hadongz/CodeName02/CodeName02.kicad_pcb

## KiCad design CodeName02.kicad_pcb (2025-10-10)

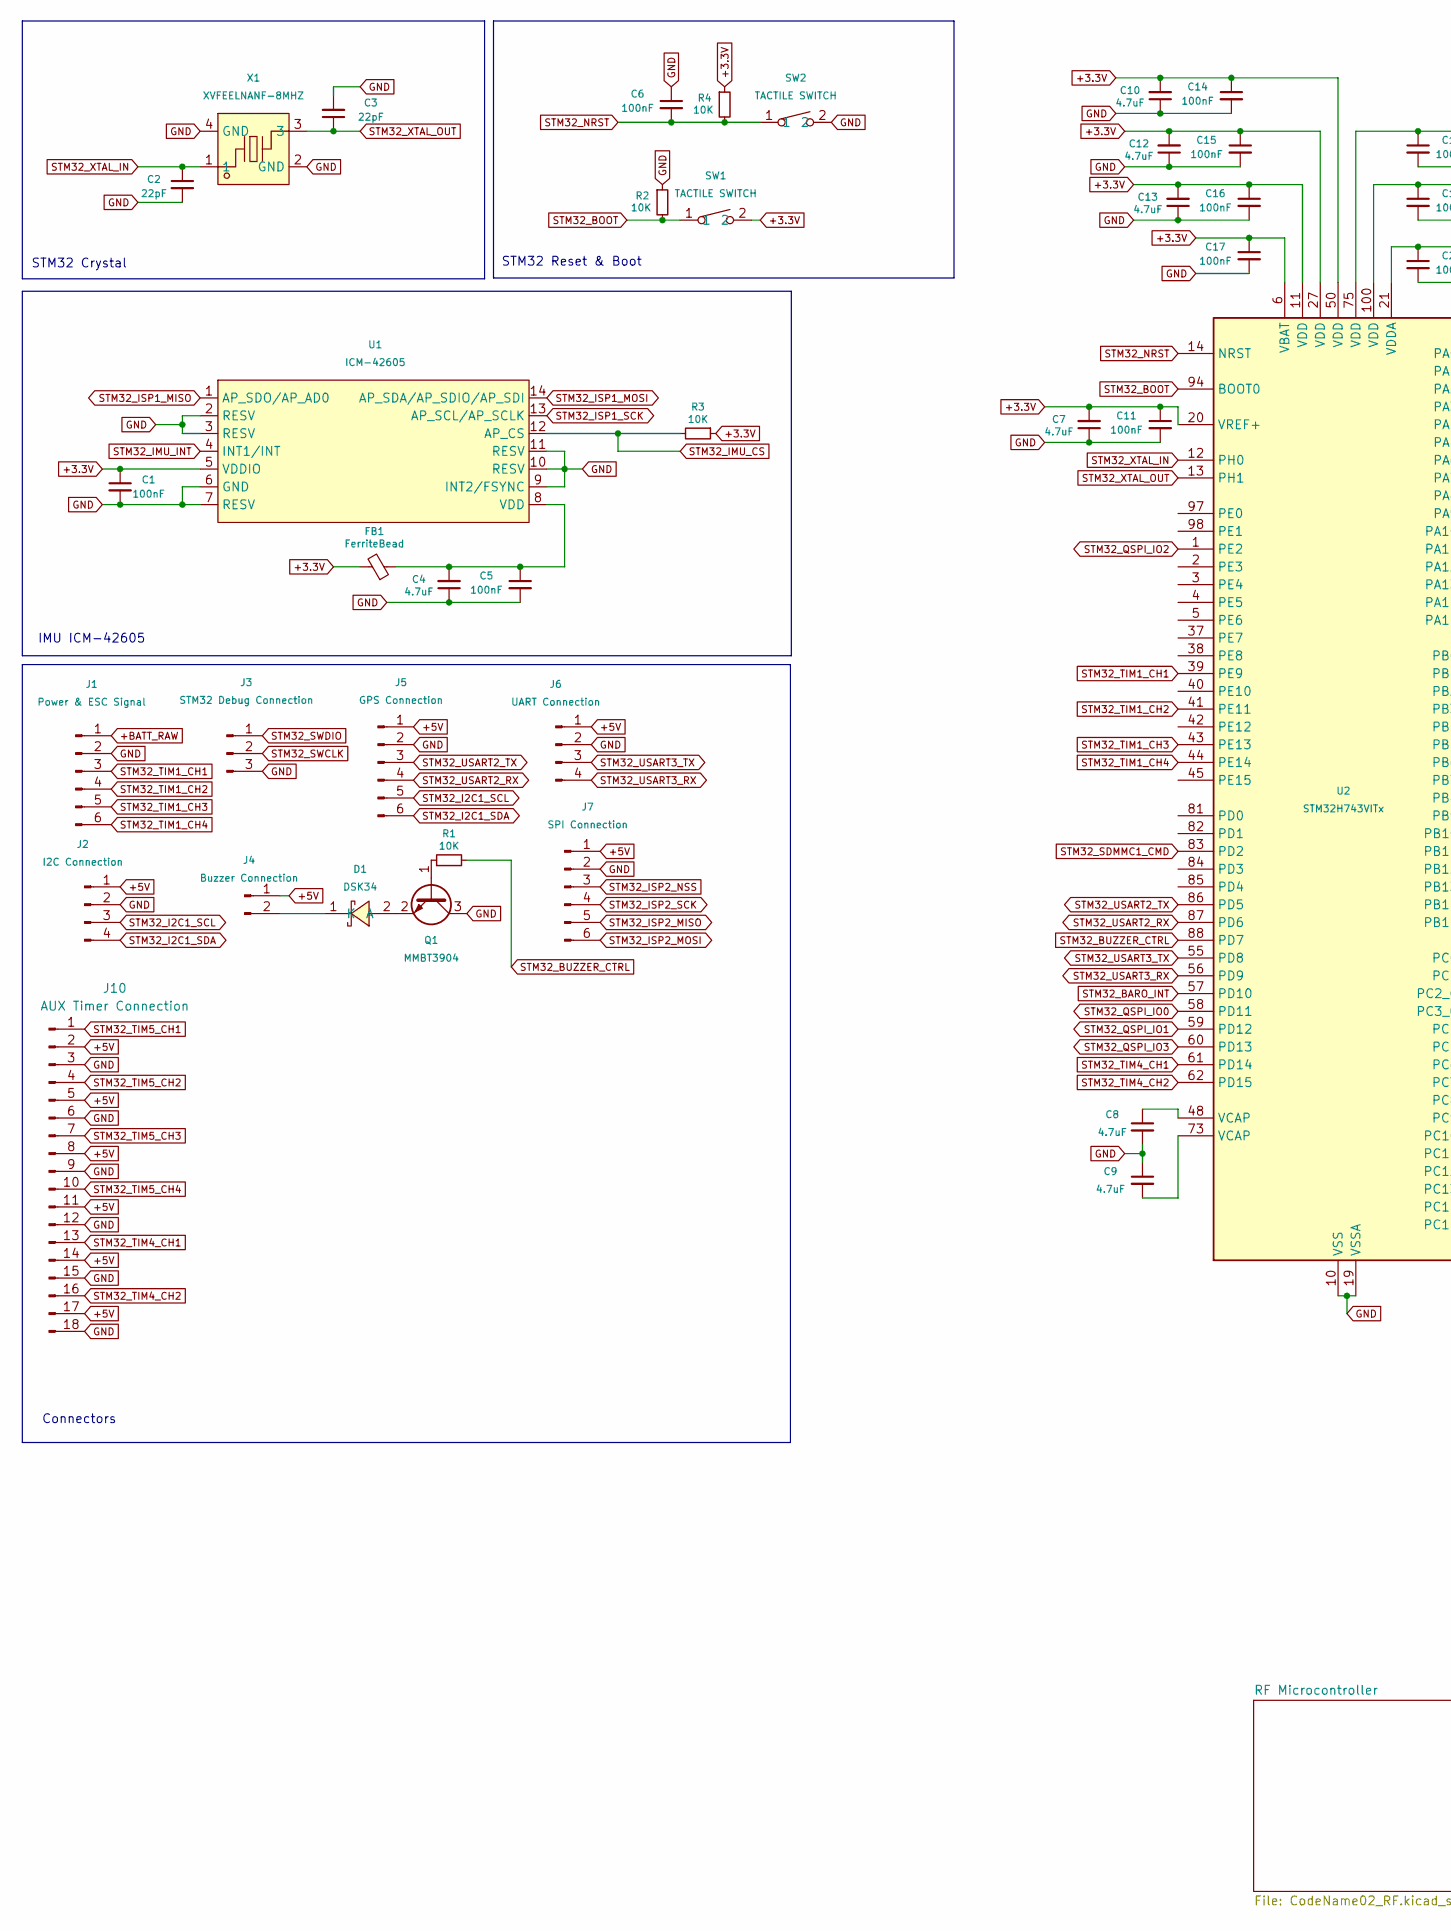
[picture p1: schematic CodeName02.kicad_sch, part in row 1, column 1]

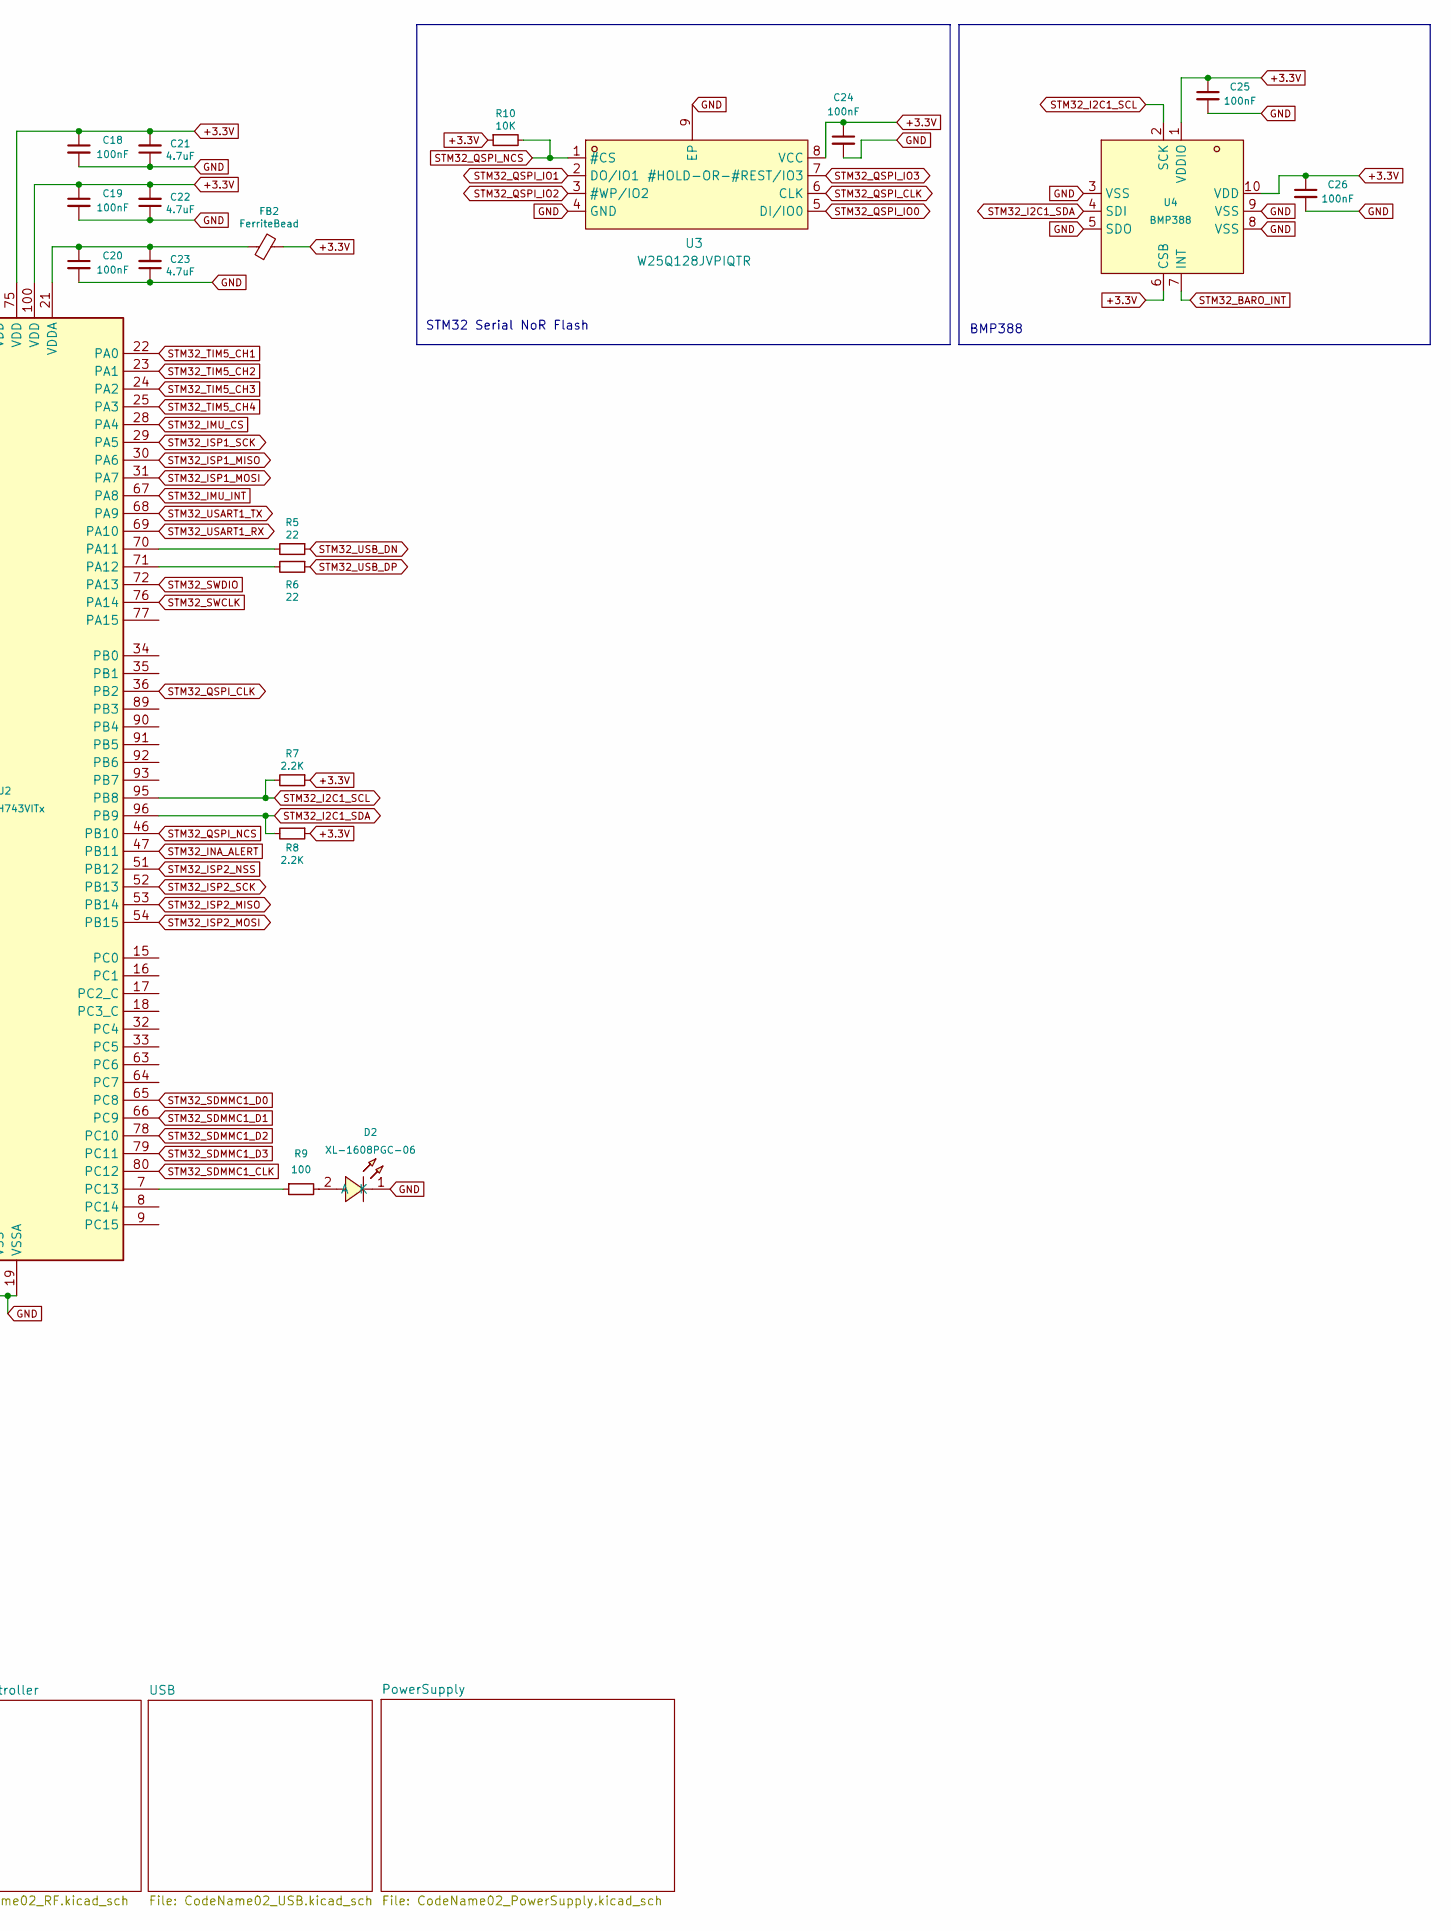
[picture p2: schematic CodeName02.kicad_sch, part in row 1, column 2]

Parts:
C1, C5, C6, C11, C14, C15, C16, C17, C18, C19, C20, C24, C25, C26: 100nF; C_0603_1608Metric
C2, C3: 22pF; C_0603_1608Metric
C4, C7, C8, C9, C10, C12, C13, C21, C22, C23: 4.7uF; C_0603_1608Metric
D1: DSK34; SOD-123FL_L2.7-W1.8-LS3.8-RD; LCSC Part C727076
D2: XL-1608PGC-06; LED0603-RD_GREEN; LCSC Part C7371905
FB1, FB2: FerriteBead; L_0603_1608Metric
J1: Power & ESC Signal; JST_GH_SM06B-GHS-TB_1x06-1MP_P1.25mm_Horizontal
J2: I2C Connection; JST_GH_BM04B-GHS-TBT_1x04-1MP_P1.25mm_Vertical
J3: STM32 Debug Connection; PinHeader_1x03_P2.54mm_Vertical_Custom
J4: Buzzer Connection; JST_GH_SM02B-GHS-TB_1x02-1MP_P1.25mm_Horizontal
J5: GPS Connection; JST_GH_SM06B-GHS-TB_1x06-1MP_P1.25mm_Horizontal
J6: UART Connection; JST_GH_SM04B-GHS-TB_1x04-1MP_P1.25mm_Horizontal
J7: SPI Connection; JST_GH_SM06B-GHS-TB_1x06-1MP_P1.25mm_Horizontal
J10: AUX Timer Connection; PinHeader_3Row_Custom
Q1: MMBT3904; SOT-23
R1, R2, R3, R4, R10: 10K; R_0603_1608Metric
R5, R6: 22; R_0603_1608Metric
R7, R8: 2.2K; R_0603_1608Metric
R9: 100; R_0603_1608Metric
SW1, SW2: TACTILE SWITCH; KEY-SMD_L4.0-W3.0-LS4.9-1; LCSC Part C49234124
U1: ICM-42605; LGA-14_L3.0-W2.5-P0.50-TL; LCSC Part C2655099
U2: STM32H743VITx; LQFP-100_14x14mm_P0.5mm
U3: W25Q128JVPIQTR; WSON-8_L6.0-W5.0-P1.27-BL; LCSC Part C190862
U4: BMP388; SENSORM-SMD_BMP388; LCSC Part C779278
X1: XVFEELNANF-8MHZ; CRYSTAL-SMD_4P-L5.0-W3.2-BL-1; LCSC Part C5160132

Connections:
+3.3V: C1.1, C7.2, C10.2, C11.1, C12.2, C13.2, C14.1, C15.1, C16.1, C17.1, C18.1, C19.1, C21.2, C22.2, C24.1, C25.1, C26.1, FB1.2, FB2.2, R3.1, R4.1, R7.1, R8.1, R10.1, SW1.2, U1.5 (VDDIO), U2.6 (VBAT), U2.11 (VDD), U2.20 (VREF+), U2.27 (VDD), U2.50 (VDD), U2.75 (VDD), U2.100 (VDD), U3.8 (VCC), U4.1 (VDDIO), U4.6 (CSB), U4.10 (VDD); also elsewhere on the board
+5V: J2.1, J4.1, J5.1, J6.1, J7.1, J10.2, J10.5, J10.8, J10.11, J10.14, J10.17; also elsewhere on the board
+BATT_RAW: J1.1; also elsewhere on the board
GND: C1.2, C2.2, C3.2, C4.1, C5.2, C6.1, C7.1, C8.2, C9.1, C10.1, C11.2, C12.1, C13.1, C14.2, C15.2, C16.2, C17.2, C18.2, C19.2, C20.2, C21.1, C22.1, C23.1, C24.2, C25.2, C26.2, D2.1 (K), J1.2, J1.MP, J2.2, J3.3, J4.MP, J5.2, J5.MP, J6.2, J6.MP, J7.2, J7.MP, J10.3, J10.6, J10.9, J10.12, J10.15, J10.18, Q1.3 (C), R2.1, SW2.2, U1.2 (RESV), U1.3 (RESV), U1.6 (GND), U1.7 (RESV), U1.9 (INT2/FSYNC), U1.10 (RESV), U1.11 (RESV), U2.10 (VSS), U2.19 (VSSA), U2.26 (VSS), U2.49 (VSS), U2.74 (VSS), U2.99 (VSS), U3.4 (GND), U3.9 (EP), U4.3 (VSS), U4.5 (SDO), U4.8 (VSS), U4.9 (VSS), X1.2 (GND), X1.4 (GND); also elsewhere on the board
unnamed: C8.1, U2.48 (VCAP)
unnamed: C9.2, U2.73 (VCAP)
unnamed: D1.2 (A), Q1.2 (E)
unnamed: D1.1 (K), J4.2
unnamed: D2.2 (A), R9.2
unnamed: Q1.1 (B), R1.1
unnamed: C4.2, C5.1, FB1.1, U1.8 (VDD)
unnamed: R5.2, U2.70 (PA11)
unnamed: R6.2, U2.71 (PA12)
unnamed: R9.1, U2.7 (PC13)
unnamed: C20.1, C23.2, FB2.1, U2.21 (VDDA)
STM32_BARO_INT: U2.57 (PD10), U4.7 (INT)
STM32_BOOT: R2.2, SW1.1, U2.94 (BOOT0)
STM32_BUZZER_CTRL: R1.2, U2.88 (PD7)
STM32_I2C1_SCL: J2.3, J5.5, R7.2, U2.95 (PB8), U4.2 (SCK); also elsewhere on the board
STM32_I2C1_SDA: J2.4, J5.6, R8.2, U2.96 (PB9), U4.4 (SDI); also elsewhere on the board
STM32_IMU_CS: R3.2, U1.12 (AP_CS), U2.28 (PA4)
STM32_IMU_INT: U1.4 (INT1/INT), U2.67 (PA8)
STM32_INA_ALERT: U2.47 (PB11); also elsewhere on the board
STM32_ISP1_MISO: U1.1 (AP_SDO/AP_AD0), U2.30 (PA6)
STM32_ISP1_MOSI: U1.14 (AP_SDA/AP_SDIO/AP_SDI), U2.31 (PA7)
STM32_ISP1_SCK: U1.13 (AP_SCL/AP_SCLK), U2.29 (PA5)
STM32_ISP2_MISO: J7.5, U2.53 (PB14)
STM32_ISP2_MOSI: J7.6, U2.54 (PB15)
STM32_ISP2_NSS: J7.3, U2.51 (PB12)
STM32_ISP2_SCK: J7.4, U2.52 (PB13)
STM32_NRST: C6.2, R4.2, SW2.1, U2.14 (NRST)
STM32_QSPI_CLK: U2.36 (PB2), U3.6 (CLK)
STM32_QSPI_IO0: U2.58 (PD11), U3.5 (DI/IO0)
STM32_QSPI_IO1: U2.59 (PD12), U3.2 (DO/IO1)
STM32_QSPI_IO2: U2.1 (PE2), U3.3 (#WP/IO2)
STM32_QSPI_IO3: U2.60 (PD13), U3.7 (#HOLD-OR-#REST/IO3)
STM32_QSPI_NCS: R10.2, U2.46 (PB10), U3.1 (#CS)
STM32_SDMMC1_CLK: U2.80 (PC12)
STM32_SDMMC1_CMD: U2.83 (PD2)
STM32_SDMMC1_D0: U2.65 (PC8)
STM32_SDMMC1_D1: U2.66 (PC9)
STM32_SDMMC1_D2: U2.78 (PC10)
STM32_SDMMC1_D3: U2.79 (PC11)
STM32_SWCLK: J3.2, U2.76 (PA14)
STM32_SWDIO: J3.1, U2.72 (PA13)
STM32_TIM1_CH1: J1.3, U2.39 (PE9)
STM32_TIM1_CH2: J1.4, U2.41 (PE11)
STM32_TIM1_CH3: J1.5, U2.43 (PE13)
STM32_TIM1_CH4: J1.6, U2.44 (PE14)
STM32_TIM4_CH1: J10.13, U2.61 (PD14)
STM32_TIM4_CH2: J10.16, U2.62 (PD15)
STM32_TIM5_CH1: J10.1, U2.22 (PA0)
STM32_TIM5_CH2: J10.4, U2.23 (PA1)
STM32_TIM5_CH3: J10.7, U2.24 (PA2)
STM32_TIM5_CH4: J10.10, U2.25 (PA3)
STM32_USART1_RX: U2.69 (PA10); also elsewhere on the board
STM32_USART1_TX: U2.68 (PA9); also elsewhere on the board
STM32_USART2_RX: J5.4, U2.87 (PD6)
STM32_USART2_TX: J5.3, U2.86 (PD5)
STM32_USART3_RX: J6.4, U2.56 (PD9)
STM32_USART3_TX: J6.3, U2.55 (PD8)
STM32_USB_DN: R5.1; also elsewhere on the board
STM32_USB_DP: R6.1; also elsewhere on the board
STM32_XTAL_IN: C2.1, U2.12 (PH0), X1.1
STM32_XTAL_OUT: C3.1, U2.13 (PH1), X1.3

Notes on the sheet:
STM32 Crystal
STM32 Reset & Boot
Connectors
BMP388
STM32 Serial NoR Flash
IMU ICM-42605

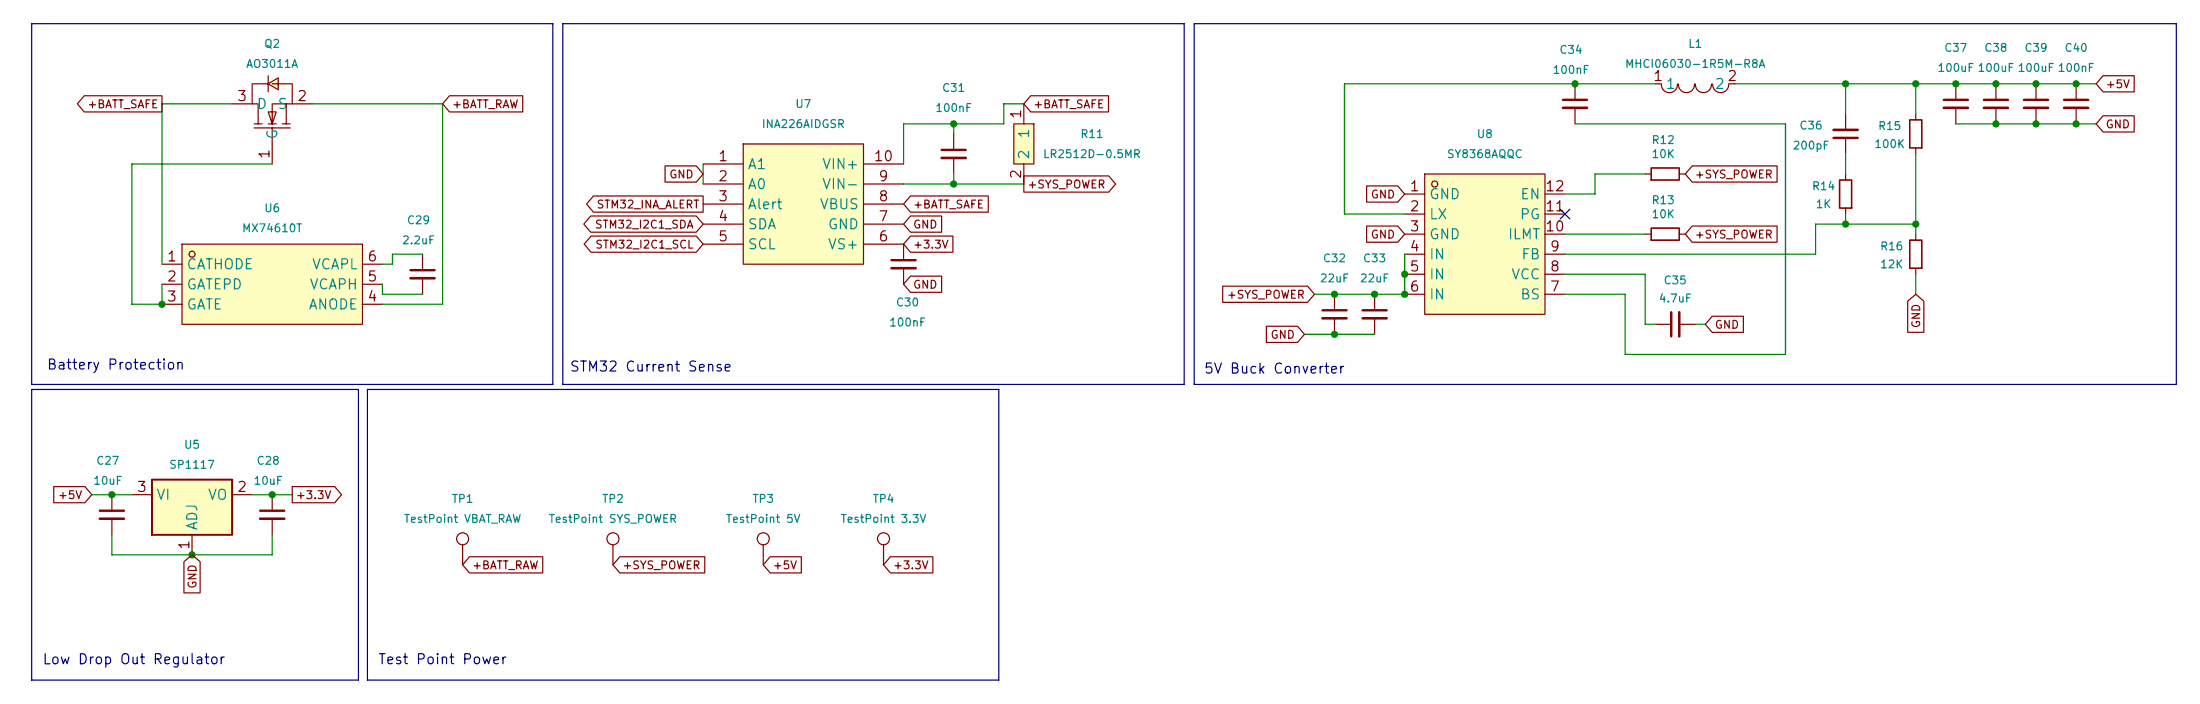
[picture p3: schematic CodeName02_PowerSupply.kicad_sch]

Parts:
C27, C28: 10uF; C_0805_2012Metric
C29: 2.2uF; C_0603_1608Metric
C30, C31, C34, C40: 100nF; C_0603_1608Metric
C32, C33: 22uF; C_0805_2012Metric
C35: 4.7uF; C_0603_1608Metric
C36: 200pF; C_0603_1608Metric
C37, C38, C39: 100uF; C_1206_3216Metric
L1: MHCI06030-1R5M-R8A; IND-SMD_L7.3-W6.6; LCSC Part C329386
Q2: AO3011A; SOT-23-3_L2.9-W1.6-P1.90-LS2.8-BR; LCSC Part C49046454
R11: LR2512D-0.5MR; RES-SMD_L6.4-W3.2_C500733; LCSC Part C500733
R12, R13: 10K; R_0603_1608Metric
R14: 1K; R_0603_1608Metric
R15: 100K; R_0603_1608Metric
R16: 12K; R_0603_1608Metric
TP1: TestPoint VBAT_RAW; TestPoint_Pad_D2.0mm
TP2: TestPoint SYS_POWER; TestPoint_Pad_D2.0mm
TP3: TestPoint 5V; TestPoint_Pad_D2.0mm
TP4: TestPoint 3.3V; TestPoint_Pad_D2.0mm
U5: SP1117; SOT-223-3_TabPin2
U6: MX74610T; SOT-23-6_L2.9-W1.6-P0.95-LS2.8-BL-1; LCSC Part C19078229
U7: INA226AIDGSR; MSOP-10_L3.0-W3.0-P0.50-LS5.0-BL; LCSC Part C49851
U8: SY8368AQQC; QFN-12_L3.0-W3.0-P0.45-TL-EP; LCSC Part C207642

Connections:
+3.3V: C28.1, C30.1, TP4.1, U5.2 (VO), U7.6 (VS+); also elsewhere on the board
+5V: C27.1, C36.2, C37.1, C38.1, C39.1, C40.1, L1.2, R15.2, TP3.1, U5.3 (VI); also elsewhere on the board
+BATT_RAW: Q2.2 (S), TP1.1, U6.4 (ANODE); also elsewhere on the board
+BATT_SAFE: C31.1, Q2.3 (D), R11.1, U6.1 (CATHODE), U7.8 (VBUS), U7.10 (VIN+)
+SYS_POWER: C31.2, C32.1, C33.1, R11.2, R12.2, R13.2, TP2.1, U7.9 (VIN-), U8.4 (IN), U8.5 (IN), U8.6 (IN); also elsewhere on the board
GND: C27.2, C28.2, C30.2, C32.2, C33.2, C35.2, C37.2, C38.2, C39.2, C40.2, R16.1, U5.1 (ADJ), U7.1 (A1), U7.2 (A0), U7.7 (GND), U8.1 (GND), U8.3 (GND); also elsewhere on the board
unnamed: C36.1, R14.2
unnamed: Q2.1 (G), U6.2 (GATEPD), U6.3 (GATE)
unnamed: C29.2, U6.5 (VCAPH)
unnamed: C29.1, U6.6 (VCAPL)
unnamed: C34.2, U8.7 (BS)
unnamed: R12.1, U8.12 (EN)
unnamed: R14.1, R15.1, R16.2, U8.9 (FB)
unnamed: R13.1, U8.10 (ILMT)
unnamed: C34.1, L1.1, U8.2 (LX)
unnamed: C35.1, U8.8 (VCC)
STM32_I2C1_SCL: U7.5 (SCL); also elsewhere on the board
STM32_I2C1_SDA: U7.4 (SDA); also elsewhere on the board
STM32_INA_ALERT: U7.3 (Alert); also elsewhere on the board

Notes on the sheet:
Low Drop Out Regulator
Test Point Power
Battery Protection
5V Buck Converter
STM32 Current Sense

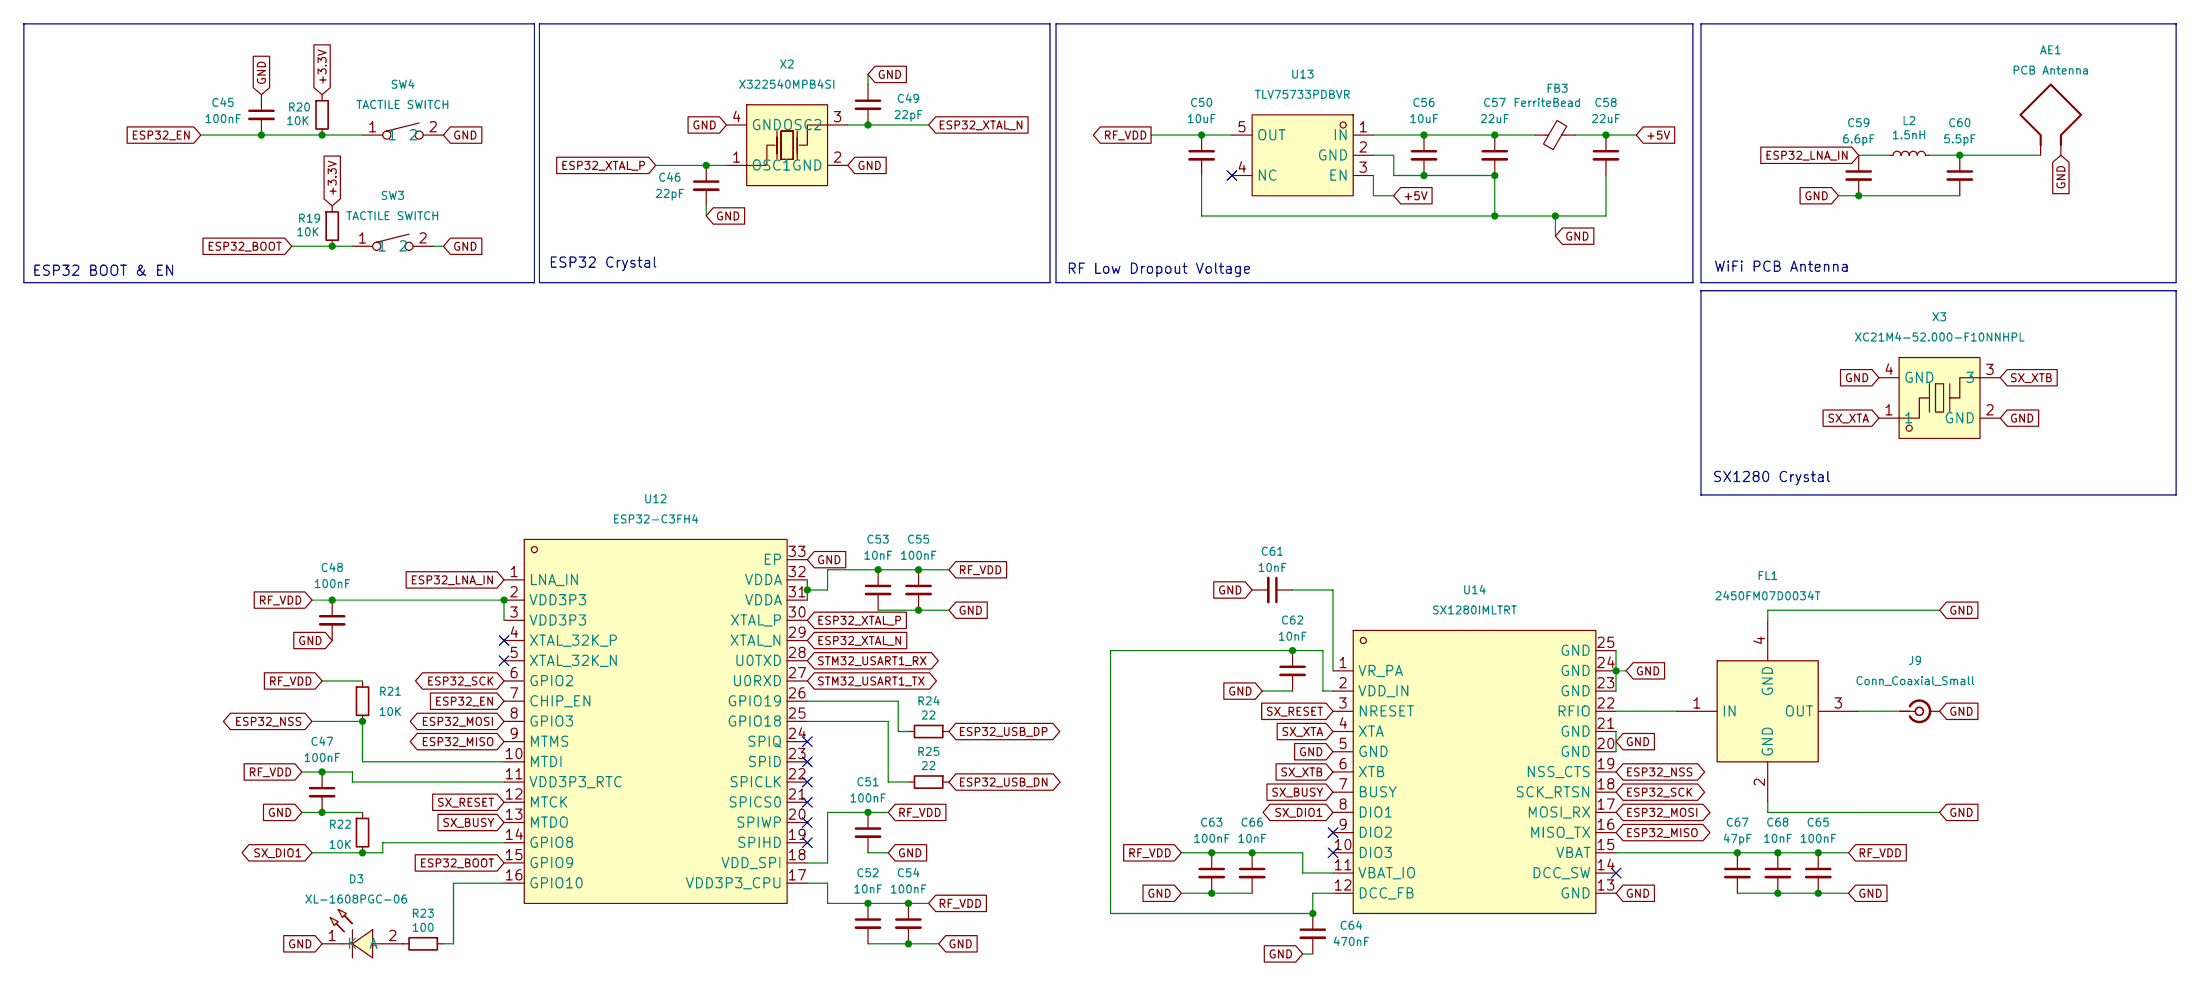
[picture p4: schematic CodeName02_RF.kicad_sch]

Parts:
AE1: PCB Antenna; Texas_SWRA117D_2.4GHz_Right
C45, C47, C48, C51, C54, C55, C63, C65: 100nF; C_0603_1608Metric
C46, C49: 22pF; C_0603_1608Metric
C50, C56: 10uF; C_0603_1608Metric
C52, C53, C61, C62, C66, C68: 10nF; C_0603_1608Metric
C57, C58: 22uF; C_0603_1608Metric
C59: 6.6pF; C_0402_1005Metric
C60: 5.5pF; C_0402_1005Metric
C64: 470nF; C_0603_1608Metric
C67: 47pF; C_0402_1005Metric
D3: XL-1608PGC-06; LED0603-RD_GREEN; LCSC Part C7371905
FB3: FerriteBead; L_0603_1608Metric
FL1: 2450FM07D0034T; FILTER-SMD_4P-L1.0-W0.5-L; LCSC Part C2651081
J9: Conn_Coaxial_Small; U.FL_Hirose_U.FL-R-SMT-1_Vertical
L2: 1.5nH; L_0402_1005Metric
R19, R20, R21, R22: 10K; R_0603_1608Metric
R23: 100; R_0603_1608Metric
R24, R25: 22; R_0603_1608Metric
SW3, SW4: TACTILE SWITCH; KEY-SMD_L4.0-W3.0-LS4.9-1; LCSC Part C49234124
U12: ESP32-C3FH4; QFN-32_L5.0-W5.0-P0.50-TL-EP3.7; LCSC Part C2858491
U13: TLV75733PDBVR; SOT-23-5_L2.9-W1.6-P0.95-LS2.8-BL; LCSC Part C485517
U14: SX1280IMLTRT; QFN-24_L4.0-W4.0-P0.50-BL-EP2.6; LCSC Part C125969
X2: X322540MPB4SI; OSC-SMD_4P-L3.2-W2.5-BL_SIT8008BI; LCSC Part C9010
X3: XC21M4-52.000-F10NNHPL; CRYSTAL-SMD_4P-L2.0-W1.6-BL; LCSC Part C3034316

Connections:
+3.3V: R19.1, R20.1; also elsewhere on the board
+5V: C58.1, FB3.2, U13.3 (EN); also elsewhere on the board
ESP32_BOOT: R19.2, SW3.1, U12.15 (GPIO9)
ESP32_EN: C45.2, R20.2, SW4.1, U12.7 (CHIP_EN)
ESP32_LNA_IN: C59.1, L2.1, U12.1 (LNA_IN)
ESP32_MISO: U12.9 (MTMS), U14.16 (MISO_TX)
ESP32_MOSI: U12.8 (GPIO3), U14.17 (MOSI_RX)
ESP32_NSS: R21.2, U12.10 (MTDI), U14.19 (NSS_CTS)
ESP32_SCK: U12.6 (GPIO2), U14.18 (SCK_RTSN)
ESP32_USB_DN: R25.1; also elsewhere on the board
ESP32_USB_DP: R24.1; also elsewhere on the board
ESP32_XTAL_N: C49.2, U12.29 (XTAL_N), X2.3 (OSC2)
ESP32_XTAL_P: C46.1, U12.30 (XTAL_P), X2.1 (OSC1)
GND: AE1.2, C45.1, C46.2, C47.2, C48.2, C49.1, C50.2, C51.2, C52.2, C53.2, C54.2, C55.2, C56.2, C57.2, C58.2, C59.2, C60.2, C61.2, C62.2, C63.2, C64.2, C65.2, C66.2, C67.2, C68.2, D3.1 (K), FL1.2 (GND), FL1.4 (GND), J9.2 (Ext), R22.1, SW3.2, SW4.2, U12.33 (EP), U13.2 (GND), U14.5 (GND), U14.13 (GND), U14.20 (GND), U14.21 (GND), U14.23 (GND), U14.24 (GND), U14.25 (GND), X2.2 (GND), X2.4 (GND), X3.2 (GND), X3.4 (GND); also elsewhere on the board
unnamed: AE1.1, C60.1, L2.2
unnamed: D3.2 (A), R23.2
unnamed: FL1.1 (IN), U14.22 (RFIO)
unnamed: FL1.3 (OUT), J9.1 (In)
unnamed: R23.1, U12.16 (GPIO10)
unnamed: R25.2, U12.25 (GPIO18)
unnamed: R24.2, U12.26 (GPIO19)
unnamed: C56.1, C57.1, FB3.1, U13.1 (IN)
unnamed: C62.1, C64.1, U14.2 (VDD_IN), U14.12 (DCC_FB)
unnamed: C61.1, U14.1 (VR_PA)
RF_VDD: C47.1, C48.1, C50.1, C51.1, C52.1, C53.1, C54.1, C55.1, C63.1, C65.1, C66.1, C67.1, C68.1, R21.1, U12.2 (VDD3P3), U12.3 (VDD3P3), U12.11 (VDD3P3_RTC), U12.17 (VDD3P3_CPU), U12.18 (VDD_SPI), U12.31 (VDDA), U12.32 (VDDA), U13.5 (OUT), U14.11 (VBAT_IO), U14.15 (VBAT)
STM32_USART1_RX: U12.28 (U0TXD); also elsewhere on the board
STM32_USART1_TX: U12.27 (U0RXD); also elsewhere on the board
SX_BUSY: U12.13 (MTDO), U14.7 (BUSY)
SX_DIO1: R22.2, U12.14 (GPIO8), U14.8 (DIO1)
SX_RESET: U12.12 (MTCK), U14.3 (NRESET)
SX_XTA: U14.4 (XTA), X3.1
SX_XTB: U14.6 (XTB), X3.3

Notes on the sheet:
ESP32 BOOT & EN
RF Low Dropout Voltage
ESP32 Crystal
SX1280 Crystal
WiFi PCB Antenna

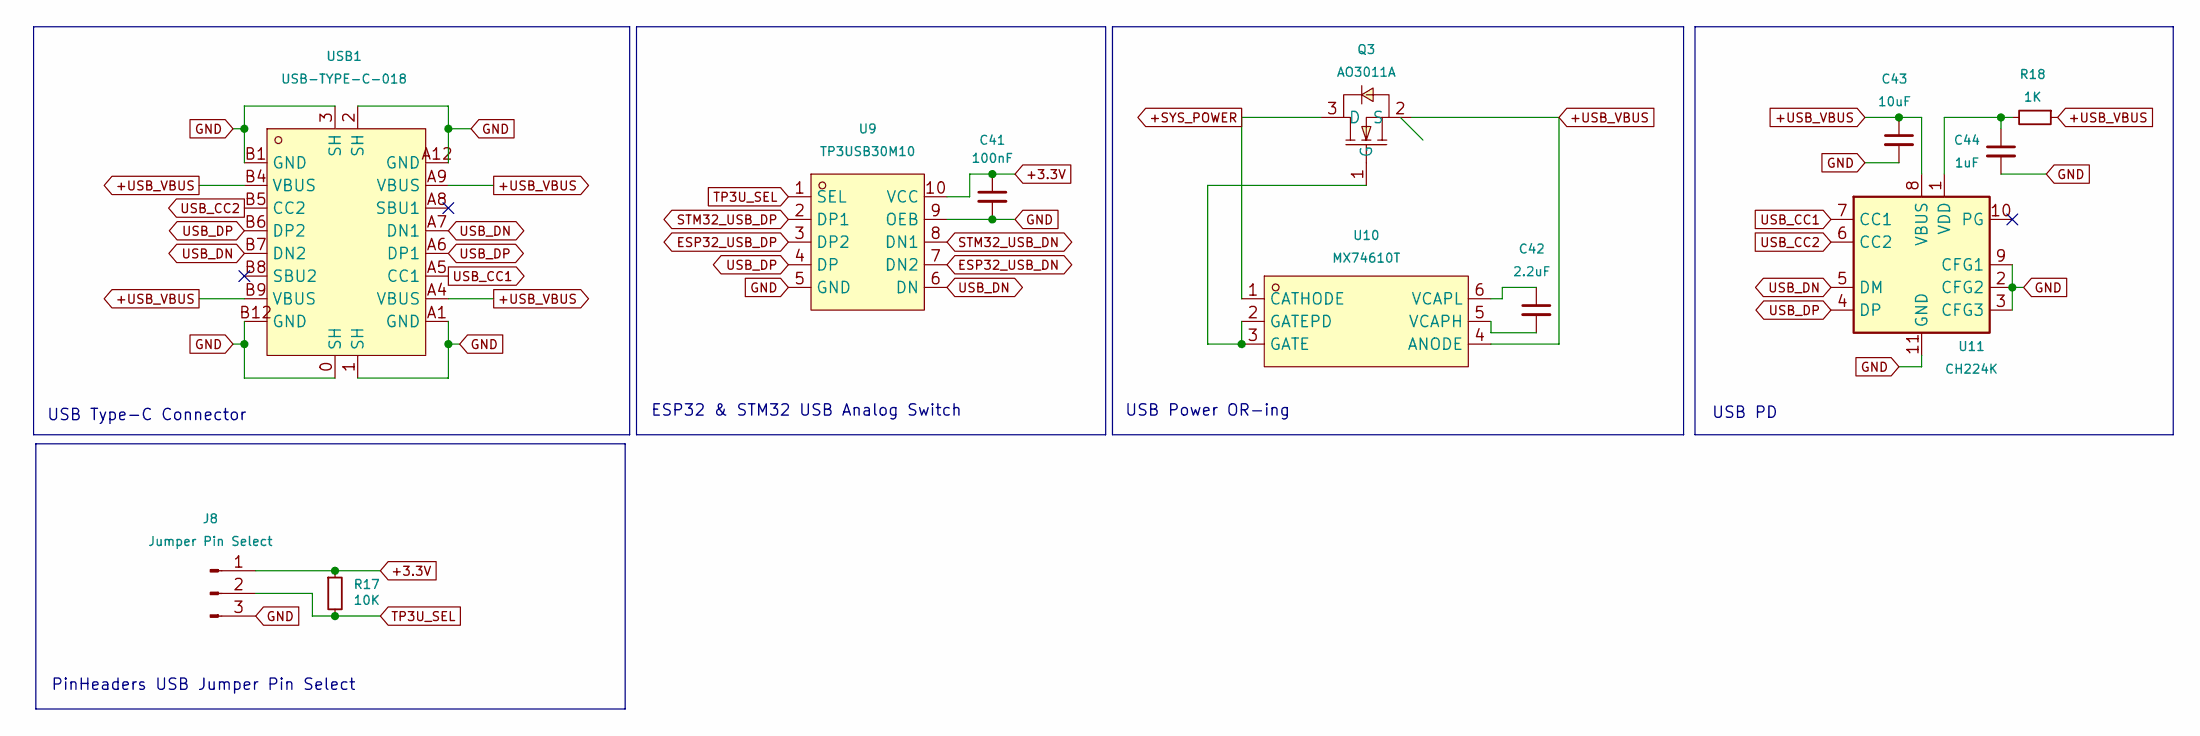
[picture p5: schematic CodeName02_USB.kicad_sch]

Parts:
C41: 100nF; C_0603_1608Metric
C42: 2.2uF; C_0603_1608Metric
C43: 10uF; C_0805_2012Metric
C44: 1uF; C_0603_1608Metric
J8: Jumper Pin Select; PinHeader_1x03_P2.54mm_Vertical_Custom
Q3: AO3011A; SOT-23-3_L2.9-W1.6-P1.90-LS2.8-BR; LCSC Part C49046454
R17: 10K; R_0603_1608Metric
R18: 1K; R_0603_1608Metric
U9: TP3USB30M10; MSOP-10_L3.0-W3.0-P0.50-LS4.9-BL; LCSC Part C2959840
U10: MX74610T; SOT-23-6_L2.9-W1.6-P0.95-LS2.8-BL-1; LCSC Part C19078229
U11: CH224K; SSOP-10-1EP_3.9x4.9mm_P1mm_EP2.1x3.3mm
USB1: USB-TYPE-C-018; USB-C_SMD-TYPE-C-31-M-12; LCSC Part C2927038

Connections:
+3.3V: C41.1, J8.1, R17.1, U9.10 (VCC); also elsewhere on the board
+SYS_POWER: Q3.3 (D), U10.1 (CATHODE); also elsewhere on the board
+USB_VBUS: C43.1, Q3.2 (S), R18.1, U10.4 (ANODE), U11.8 (VBUS), USB1.A4 (VBUS), USB1.A9 (VBUS), USB1.B4 (VBUS), USB1.B9 (VBUS)
ESP32_USB_DN: U9.7 (DN2); also elsewhere on the board
ESP32_USB_DP: U9.3 (DP2); also elsewhere on the board
GND: C41.2, C43.2, C44.2, J8.3, U9.5 (GND), U9.9 (OEB), U11.2 (CFG2), U11.3 (CFG3), U11.9 (CFG1), U11.11 (GND), USB1.0 (SH), USB1.1 (SH), USB1.2 (SH), USB1.3 (SH), USB1.A1 (GND), USB1.A12 (GND), USB1.B1 (GND), USB1.B12 (GND); also elsewhere on the board
unnamed: Q3.1 (G), U10.2 (GATEPD), U10.3 (GATE)
unnamed: C42.2, U10.5 (VCAPH)
unnamed: C42.1, U10.6 (VCAPL)
unnamed: C44.1, R18.2, U11.1 (VDD)
STM32_USB_DN: U9.8 (DN1); also elsewhere on the board
STM32_USB_DP: U9.2 (DP1); also elsewhere on the board
TP3U_SEL: J8.2, R17.2, U9.1 (SEL)
USB_CC1: U11.7 (CC1), USB1.A5 (CC1)
USB_CC2: U11.6 (CC2), USB1.B5 (CC2)
USB_DN: U9.6 (DN), U11.5 (DM), USB1.A7 (DN1), USB1.B7 (DN2)
USB_DP: U9.4 (DP), U11.4 (DP), USB1.A6 (DP1), USB1.B6 (DP2)

Notes on the sheet:
USB Power OR-ing
PinHeaders USB Jumper Pin Select
USB PD
ESP32 & STM32 USB Analog Switch
USB Type-C Connector

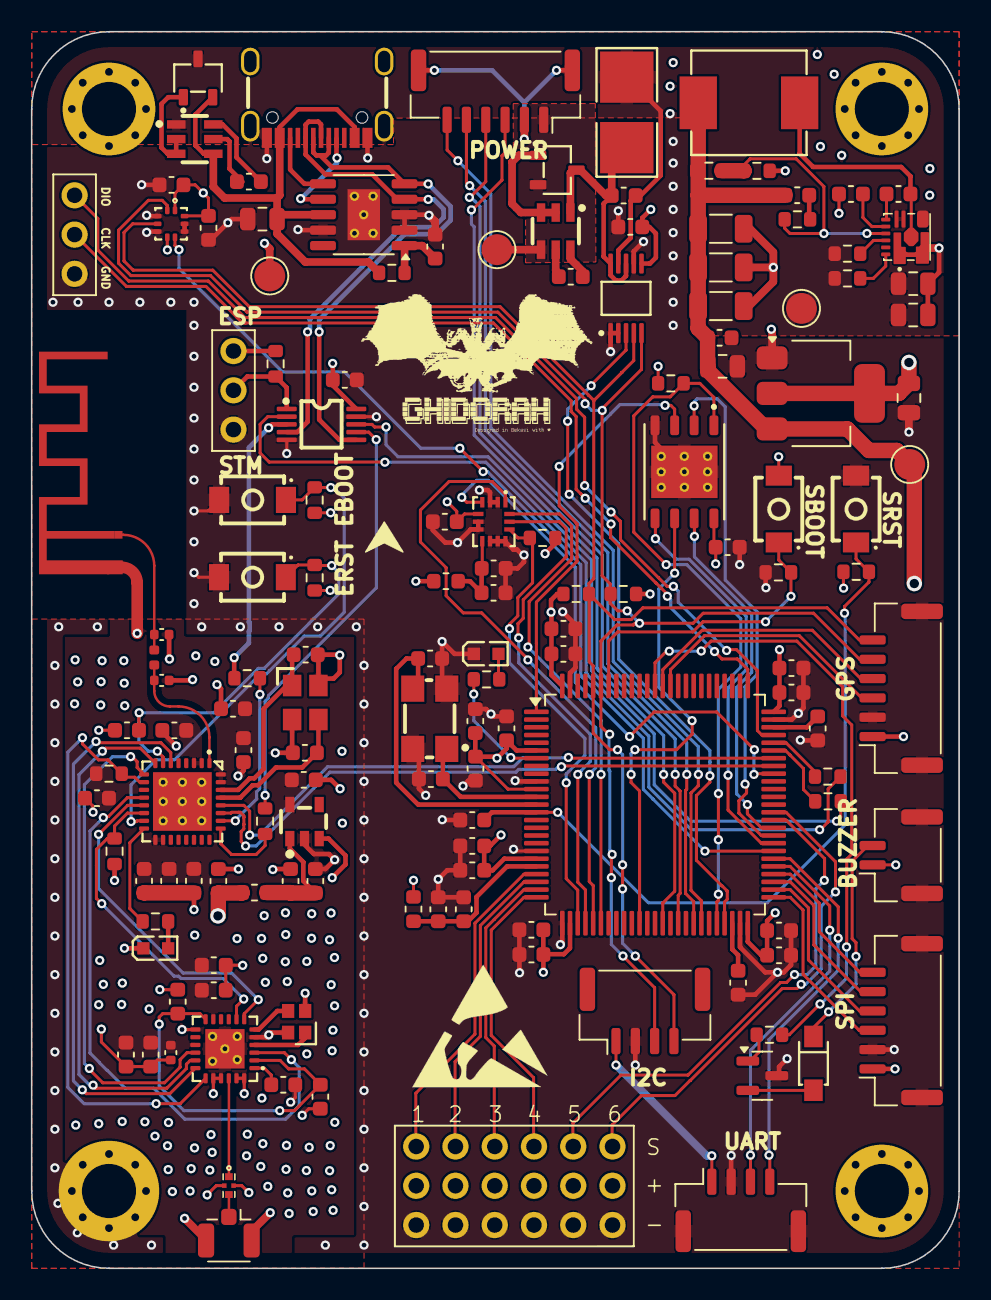
[picture p6: board CodeName02.kicad_pcb from above]

Board: 4 copper layers, 60.0 x 80.0 mm, 142 parts (0 on the bottom side), 108 nets.
