hadongz/CodeName02/(commit log)

2025-10-06 [CodeName02] Initial Commit
    [CodeName02.kicad_pcb, CodeName02.kicad_sch]
2025-10-06 chore: delete zip
    [CodeName02.kicad_pcb]
2025-10-07 feat: schematic update
    [CodeName02.kicad_sch]
2025-10-07 feat: ESP32-C3 Antenna
    [CodeName02.kicad_pcb, CodeName02.kicad_sch, CodeName02_PowerSupply.kicad_sch, CodeName02_RF.kicad_sch, CodeName02_USB.kicad_sch]
2025-10-10 feat: finalize
    [CodeName02.kicad_pcb, CodeName02.kicad_sch, CodeName02_PowerSupply.kicad_sch, CodeName02_RF.kicad_sch]
